mtsale/trapPCB-nov/trap-pcb.step

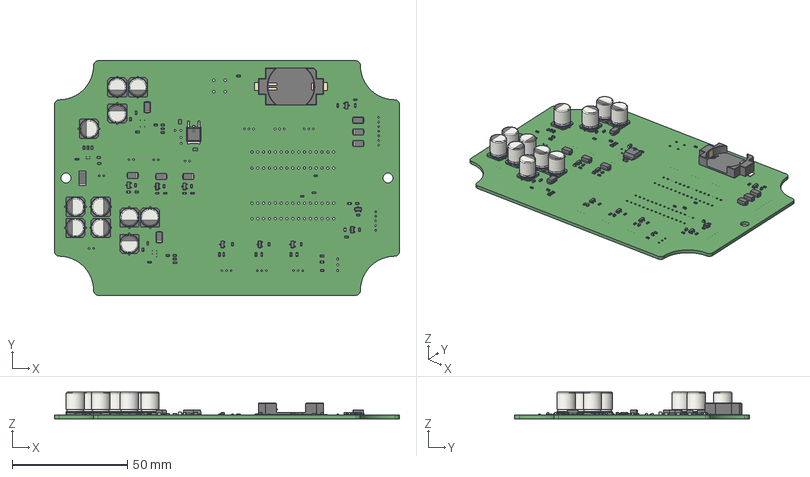
[picture p1: CAD file, 2020-11-08]
trap-pcb.step
150.0 x 102.0 x 11.7 mm
