mtsale/trapPCB-nov/trap-pcb.kicad_pcb

## KiCad design trap-pcb.kicad_pcb (2020-11-08)

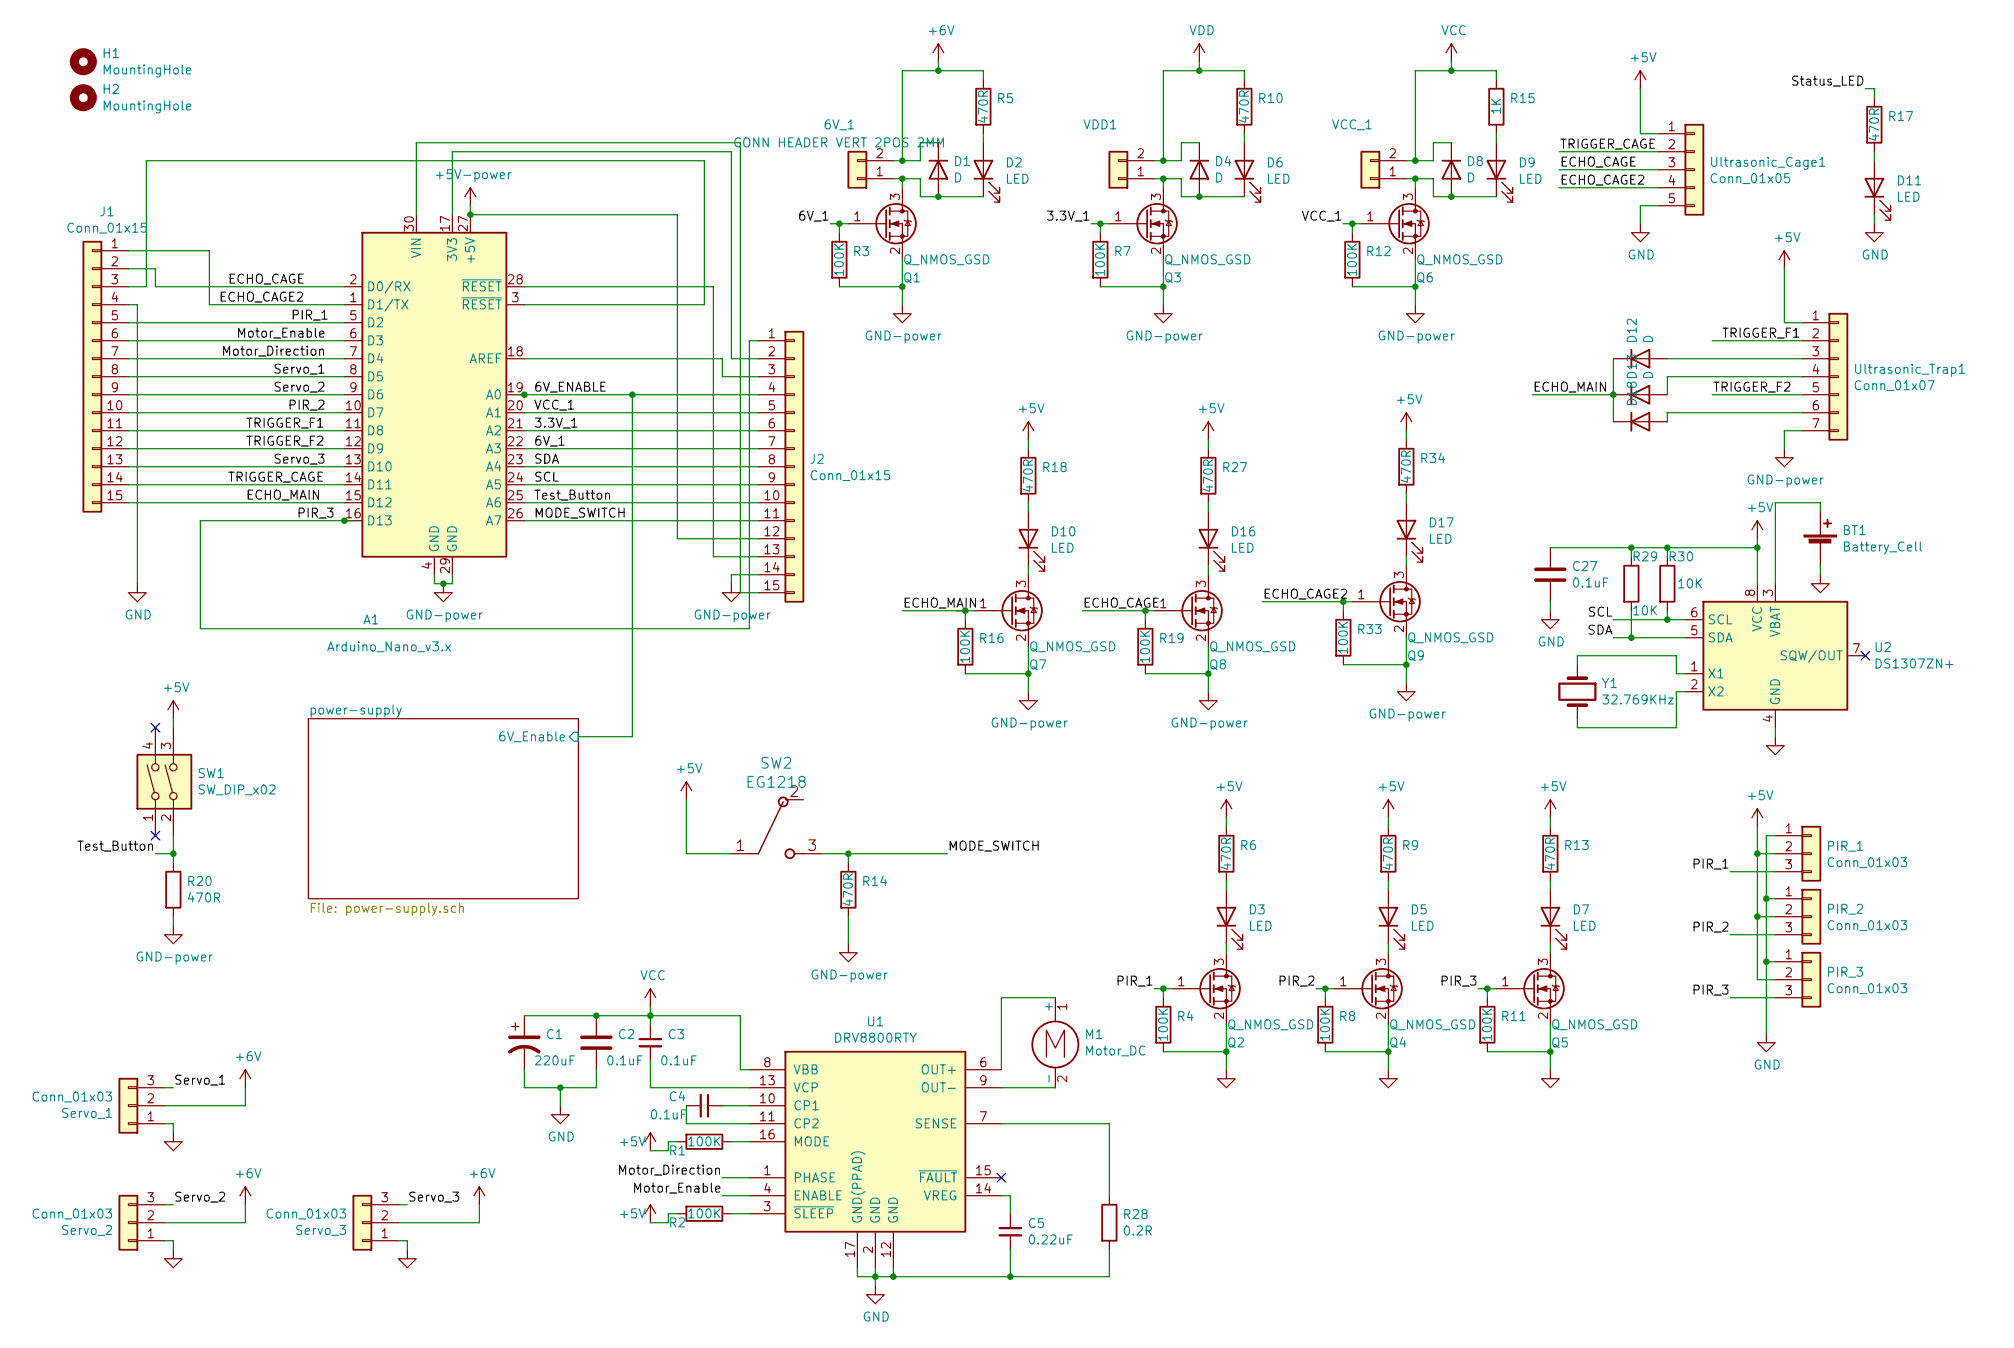
[picture p2: schematic trap-pcb.sch]

Parts:
6V_1: CONN HEADER VERT 2POS 2MM; JST_PH_B2B-PH-K_1x02_P2.00mm_Vertical; Manufacturer Part # B2B-PH-K-S(LF)(SN); DigiKey 455-1704-ND
A1: Arduino_Nano_v3.x; Arduino_Nano
BT1: Battery_Cell; BatteryHolder_Keystone_1060_1x2032; JLCPCB SMD C70377
C1: 220uF; CP_Elec_8x10; JLCPCB SMD C134765
C2, C3, C4, C27: 0.1uF; C_0603_1608Metric; JLCPCB SMD C14663
C5: 0.22uF; C_0603_1608Metric; JLCPCB SMD C21120
D1, D4, D8, D12, D13, D18: D; D_SMA; JLCPCB SMD C95872
D2, D3, D5, D6, D7, D9, D10, D11, D16, D17: LED; LED_0603_1608Metric; JLCPCB SMD C2286
H1, H2: MountingHole; MountingHole_4.3mm_M4
J1, J2: Conn_01x15; PinHeader_1x15_P2.54mm_Vertical; DigiKey S7013-ND
M1: Motor_DC; JST_PH_B2B-PH-K_1x02_P2.00mm_Vertical; DigiKey 455-1705-ND
PIR_1, PIR_2, PIR_3: Conn_01x03; JST_PH_B3B-PH-K_1x03_P2.00mm_Vertical; Manufacturer Part # B3B-PH-K-S(LF)(SN); DigiKey 455-1705-ND
Q1, Q2, Q3, Q4, Q5, Q6, Q7, Q8, Q9: Q_NMOS_GSD; SOT-23; JLCPCB SMD C20917
R1, R2, R3, R4, R7, R8, R11, R12, R16, R19, R33: 100K; R_0603_1608Metric; JLCPCB SMD C25803
R5, R6, R9, R10, R13, R14, R17, R18, R20, R27, R34: 470R; R_0603_1608Metric; JLCPCB SMD C23179
R15: 1K; R_0603_1608Metric; JLCPCB SMD C21190
R28: 0.2R; R_2512_6332Metric; JLCPCB SMD C76258
R29, R30: 10K; R_0603_1608Metric; JLCPCB SMD C39050
SW1: SW_DIP_x02; Push_E-Switch_KS01Q01; Manufacturer Part # D6C40 F2 LFS; DigiKey 401-1985-ND
SW2: EG1218; Manufacturer Part # EG1903-ND; DigiKey 455-1704-ND
Servo_1, Servo_2, Servo_3: Conn_01x03; JST_PH_B3B-PH-K_1x03_P2.00mm_Vertical; Manufacturer Part # B3B-PH-K-S(LF)(SN); DigiKey 455-1705-ND
U1: DRV8800RTY; Texas_S-PWQFN-N16_EP2.1x2.1mm_ThermalVias; JLCPCB SMD C330401
U2: DS1307ZN+; SOIC-8_3.9x4.9mm_P1.27mm; JLCPCB SMD C26858
Ultrasonic_Cage1: Conn_01x05; JST_PH_B5B-PH-K_1x05_P2.00mm_Vertical; Manufacturer Part # B5B-PH-K-S(LF)(SN); DigiKey 455-1707-ND
Ultrasonic_Trap1: Conn_01x07; JST_PH_B7B-PH-K_1x07_P2.00mm_Vertical; Manufacturer Part # B5B-PH-K-S(LF)(SN); DigiKey 455-1707-ND
VCC_1: CONN HEADER VERT 2POS 2MM; JST_PH_B2B-PH-K_1x02_P2.00mm_Vertical; Manufacturer Part # B2B-PH-K-S(LF)(SN); DigiKey 455-1704-ND
VDD1: CONN HEADER VERT 2POS 2MM; JST_PH_B2B-PH-K_1x02_P2.00mm_Vertical; Manufacturer Part # B2B-PH-K-S(LF)(SN); DigiKey 455-1704-ND
Y1: 32.769KHz; Crystal_SMD_3215-2Pin_3.2x1.5mm; JLCPCB SMD C32346

Connections:
+6V: 6V_1.2, D1.1 (K), R5.1, Servo_1.2, Servo_2.2, Servo_3.2; also elsewhere on the board
/3.3V_1: A1.21 (A2), J2.6, Q3.1 (G), R7.1
/6V_1: A1.22 (A3), J2.7, Q1.1 (G), R3.1
/6V_ENABLE: A1.19 (A0), J2.4; also elsewhere on the board
/ECHO_CAGE: A1.2 (D0/RX), J1.2, Q8.1 (G), R19.1, Ultrasonic_Cage1.3
/ECHO_CAGE2: A1.1 (D1/TX), J1.1, Q9.1 (G), R33.1, Ultrasonic_Cage1.4
/ECHO_MAIN: A1.15 (D12), D12.1 (K), D13.1 (K), D18.1 (K), J1.15, Q7.1 (G), R16.1
/MODE_SWITCH: A1.26 (A7), J2.11, R14.1, SW2.3
/Motor_Direction: A1.7 (D4), J1.7, U1.1 (PHASE)
/Motor_Enable: A1.6 (D3), J1.6, U1.4 (ENABLE)
/PIR_1: A1.5 (D2), J1.5, PIR_1.3, Q2.1 (G), R4.1
/PIR_2: A1.10 (D7), J1.10, PIR_2.3, Q4.1 (G), R8.1
/PIR_3: A1.16 (D13), J2.1, PIR_3.3, Q5.1 (G), R11.1
/SCL: A1.24 (A5), J2.9, R30.2, U2.6 (SCL)
/SDA: A1.23 (A4), J2.8, R29.2, U2.5 (SDA)
/Servo_1: A1.8 (D5), J1.8, Servo_1.3
/Servo_2: A1.9 (D6), J1.9, Servo_2.3
/Servo_3: A1.13 (D10), J1.13, Servo_3.3
/Status_LED: R17.1
/TRIGGER_CAGE: A1.14 (D11), J1.14, Ultrasonic_Cage1.2
/TRIGGER_F1: A1.11 (D8), J1.11, Ultrasonic_Trap1.2
/TRIGGER_F2: A1.12 (D9), J1.12, Ultrasonic_Trap1.5
/Test_Button: A1.25 (A6), J2.10, R20.1, SW1.2
/VCC_1: A1.20 (A1), J2.5, Q6.1 (G), R12.1
unnamed: 6V_1.1, D1.2 (A), D2.1 (K), Q1.3 (D)
unnamed: A1.3 (~RESET), J1.3
unnamed: A1.17 (3V3), J2.2
unnamed: A1.18 (AREF), J2.3
unnamed: A1.28 (~RESET), J2.13
unnamed: A1.30 (VIN), J2.15
unnamed: BT1.1 (+), U2.3 (VBAT)
unnamed: C3.2, U1.13 (VCP)
unnamed: C4.1, U1.10 (CP1)
unnamed: C4.2, U1.11 (CP2)
unnamed: C5.1, U1.14 (VREG)
unnamed: D2.2 (A), R5.2
unnamed: D3.1 (K), Q2.3 (D)
unnamed: D3.2 (A), R6.2
unnamed 44: D4.2 (A), D6.1 (K), Q3.3 (D), VDD1.1; also elsewhere on the board
unnamed: D5.1 (K), Q4.3 (D)
unnamed: D5.2 (A), R9.2
unnamed: D6.2 (A), R10.2
unnamed: D7.1 (K), Q5.3 (D)
unnamed: D7.2 (A), R13.2
unnamed: D8.2 (A), D9.1 (K), Q6.3 (D), VCC_1.1
unnamed: D9.2 (A), R15.2
unnamed: D10.1 (K), Q7.3 (D)
unnamed: D10.2 (A), R18.2
unnamed: D11.2 (A), R17.2
unnamed: D12.2 (A), Ultrasonic_Trap1.3
unnamed: D13.2 (A), Ultrasonic_Trap1.4
unnamed: D16.1 (K), Q8.3 (D)
unnamed: D16.2 (A), R27.2
unnamed: D17.1 (K), Q9.3 (D)
unnamed: D17.2 (A), R34.2
unnamed: D18.2 (A), Ultrasonic_Trap1.6
unnamed: M1.1 (+), U1.6 (OUT+)
unnamed: M1.2 (-), U1.9 (OUT-)
unnamed: R1.1, U1.16 (MODE)
unnamed: R2.1, U1.3 (~SLEEP)
unnamed: R28.1, U1.7 (SENSE)
unnamed: U2.1 (X1), Y1.1
unnamed: U2.2 (X2), Y1.2
VCC: C1.1, C2.1, C3.1, D8.1 (K), R15.1, U1.8 (VBB), VCC_1.2; also elsewhere on the board
VDD: D4.1 (K), R10.1, VDD1.2; also elsewhere on the board

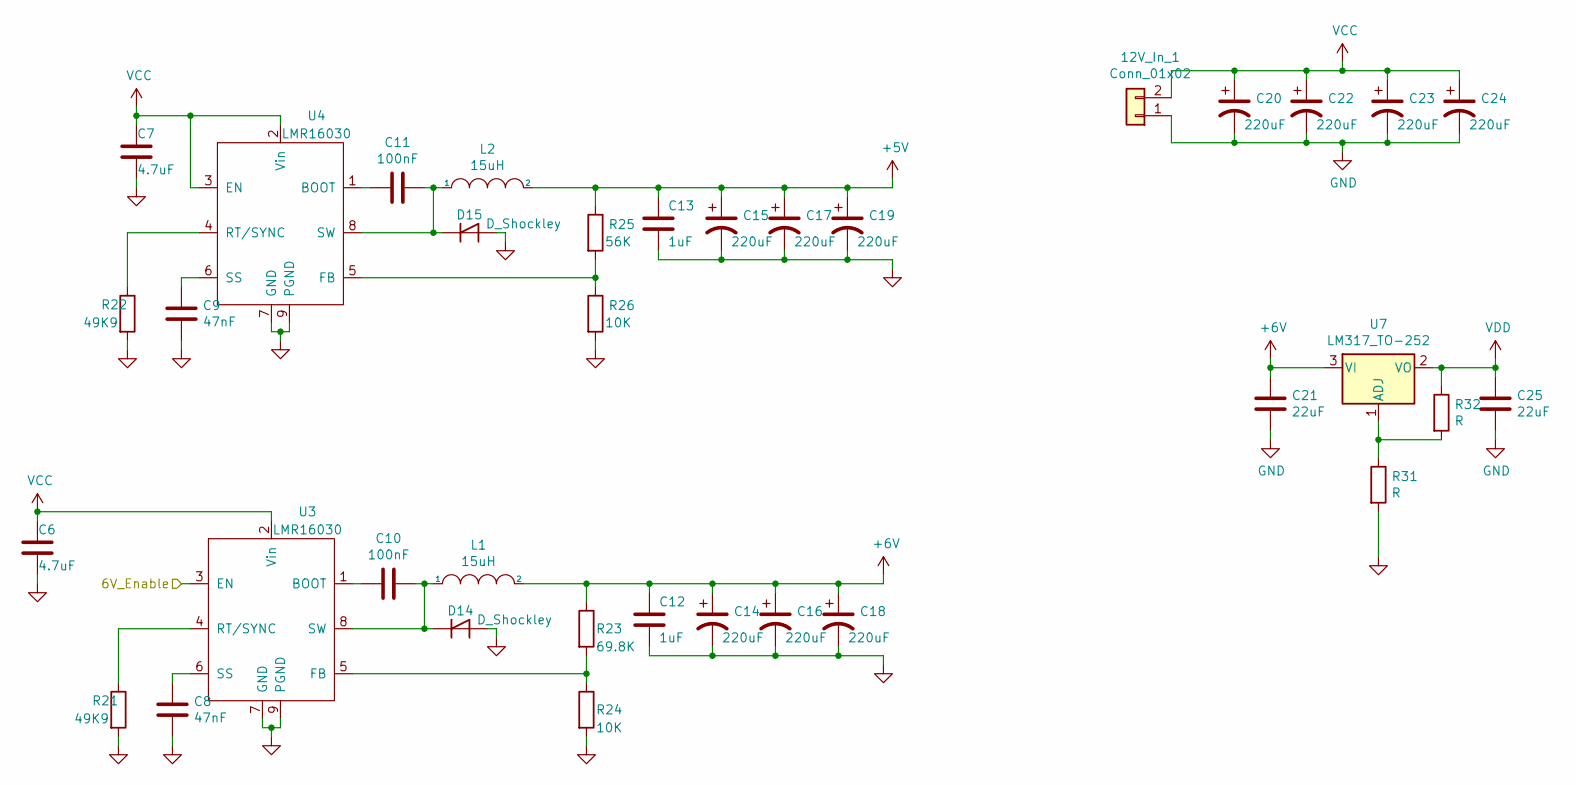
[picture p3: schematic power-supply.sch]

Parts:
12V_In_1: Conn_01x02; JST_PH_B2B-PH-K_1x02_P2.00mm_Vertical; DigiKey 455-1704-ND
C6, C7: 4.7uF; C_0603_1608Metric; JLCPCB SMD C19666
C8, C9: 47nF; C_0603_1608Metric; JLCPCB SMD C1622
C10, C11: 100nF; C_0603_1608Metric; JLCPCB SMD C14663
C12, C13: 1uF; C_0603_1608Metric; JLCPCB SMD C15849
C14, C15, C16, C17, C18, C19, C20, C22, C23, C24: 220uF; CP_Elec_8x10; JLCPCB SMD C134765
C21, C25: 22uF; C_0805_2012Metric; JLCPCB SMD C45783
D14, D15: D_Shockley; D_SMA; JLCPCB SMD C360444
L1, L2: 15uH; MWSA1004; JLCPCB SMD C151872
R21, R22: 49K9; R_0603_1608Metric; JLCPCB SMD C23184
R23: 69.8K; R_0603_1608Metric; JLCPCB SMD C23098
R24, R26: 10K; R_0603_1608Metric; JLCPCB SMD C39050
R25: 56K; R_0603_1608Metric; JLCPCB SMD C351640
R31, R32: R; R_Axial_DIN0309_L9.0mm_D3.2mm_P2.54mm_Vertical
U3, U4: LMR16030; HTSOP-8-1EP_3.9x4.9mm_P1.27mm_EP2.4x3.2mm_ThermalVias; JLCPCB SMD C90665
U7: LM317_TO-252; TO-252-2; JLCPCB SMD C75510

Connections:
+6V: C12.1, C14.1, C16.1, C18.1, C21.1, L1.2, R23.1, U7.3 (VI); also elsewhere on the board
/6V_ENABLE: U3.3 (EN); also elsewhere on the board
unnamed: C8.1, U3.6 (SS)
unnamed: C9.1, U4.6 (SS)
unnamed: C10.1, D14.1 (K), L1.1, U3.8 (SW)
unnamed: C10.2, U3.1 (BOOT)
unnamed: C11.1, D15.1 (K), L2.1, U4.8 (SW)
unnamed: C11.2, U4.1 (BOOT)
unnamed: R21.1, U3.4 (RT/SYNC)
unnamed: R22.1, U4.4 (RT/SYNC)
unnamed: R23.2, R24.1, U3.5 (FB)
unnamed: R25.2, R26.1, U4.5 (FB)
unnamed: R31.1, R32.2, U7.1 (ADJ)
VCC: 12V_In_1.2, C6.1, C7.1, C20.1, C22.1, C23.1, C24.1, U3.2 (Vin), U4.2 (Vin), U4.3 (EN); also elsewhere on the board
VDD: C25.1, R32.1, U7.2 (VO); also elsewhere on the board

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
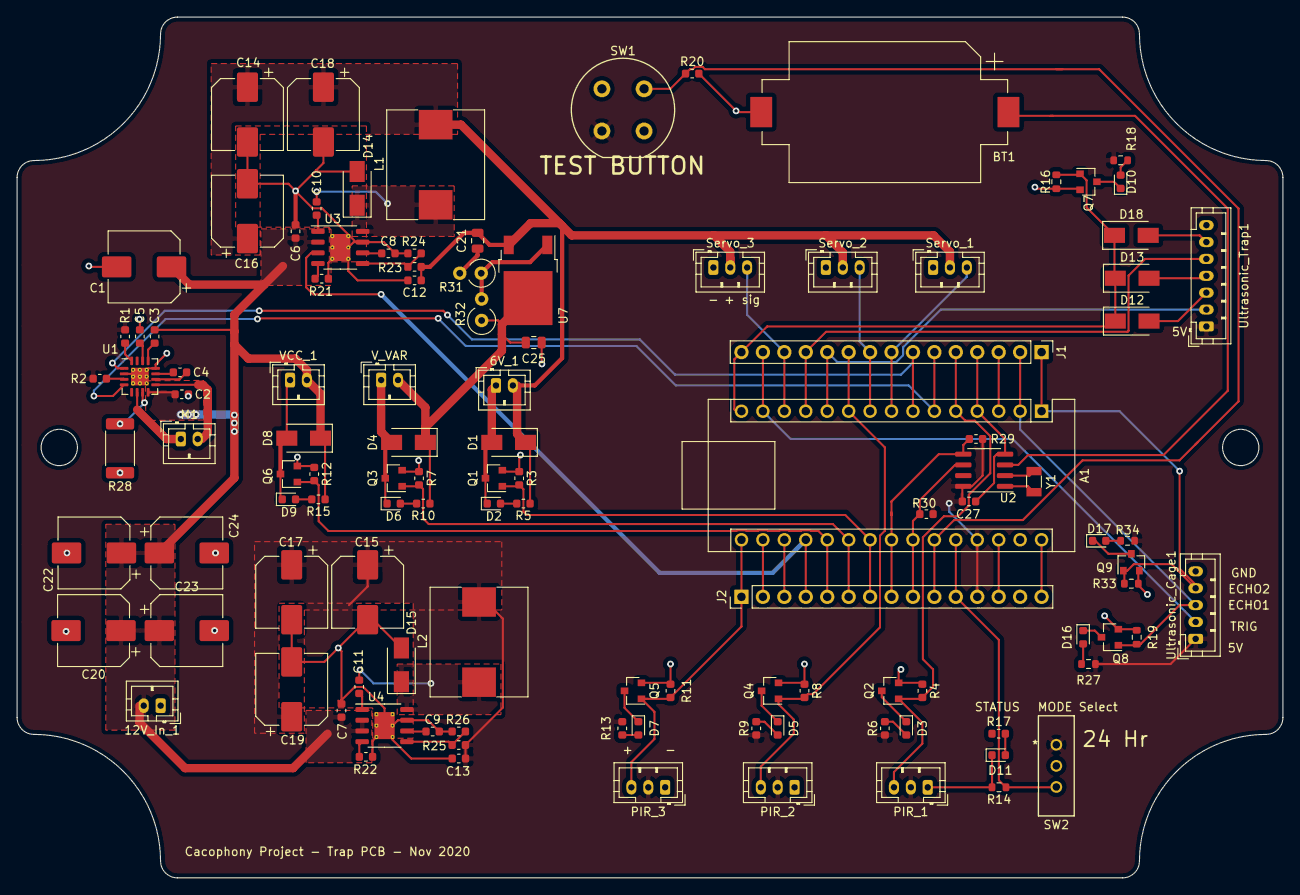
[picture p4: board trap-pcb.kicad_pcb from above]

Board: 2 copper layers, 150.0 x 102.0 mm, 116 parts (0 on the bottom side), 77 nets.

Other parts of the board:
V_VAR: CONN HEADER VERT 2POS 2MM; JST_PH_B2B-PH-K_1x02_P2.00mm_Vertical

Their connections:
unnamed 44: V_VAR.1; also elsewhere on the board
VDD: V_VAR.2; also elsewhere on the board
