mtsale/trapPCB-nov/(commit log)

2020-10-29 Add files via upload
    Initial Commit
    [power-supply.sch, trap-pcb.kicad_pcb, trap-pcb.sch, trap-pcb.step]
2020-10-30 DRC Fixes
    Fixed DRC errors. Changed connectors to JST.
    [trap-pcb.kicad_pcb]
2020-11-01 Updated 3D model
    [trap-pcb.step]
2020-11-01 minor layout and routing changes
    [trap-pcb.sch]
2020-11-08 Updated JLC and DigiKey parts
    [power-supply.sch, trap-pcb.kicad_pcb, trap-pcb.sch, trap-pcb.step]
